AdjacentReality/NodeHardware/SolidModels/sphere_top.stl

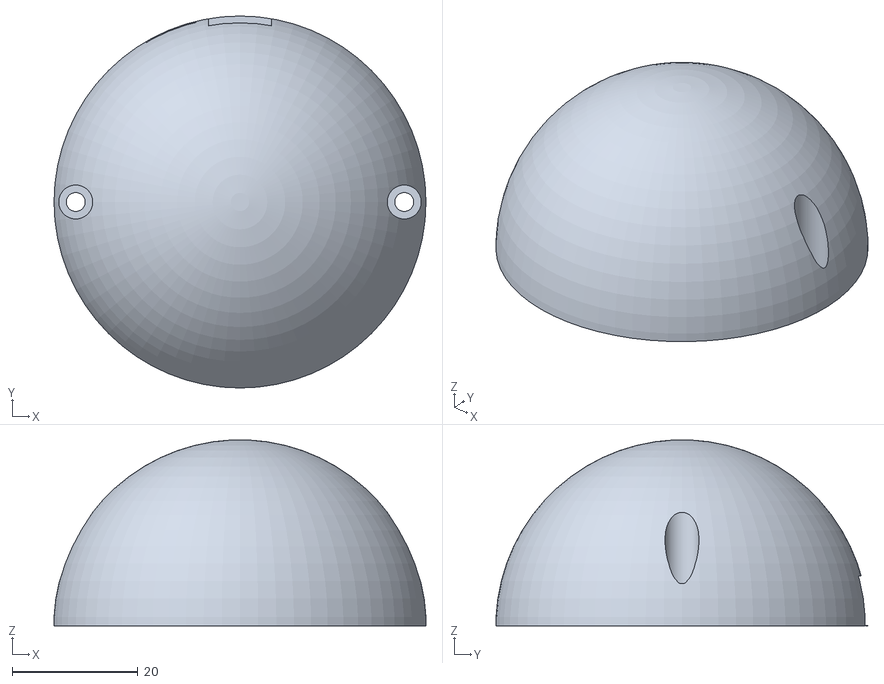
[picture p1: CAD file, 2012-06-10]
SolidModels/sphere_top.stl
59.2 x 59.2 x 29.6
