AdjacentReality/NodeHardware/SolidModels/spray_can_button.stl

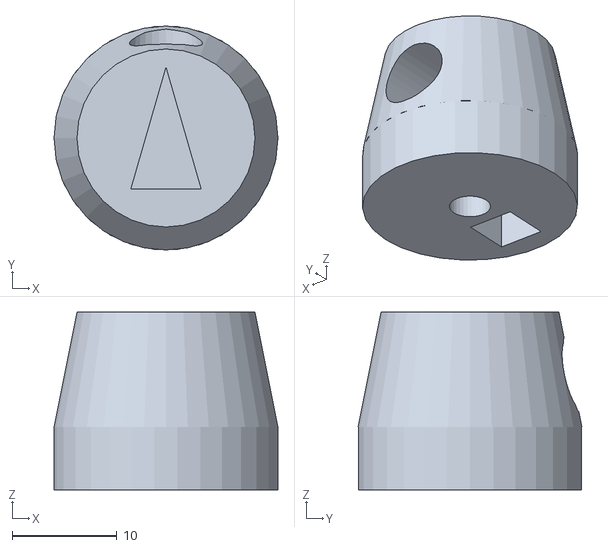
[picture p2: CAD file, 2012-05-16]
SolidModels/spray_can_button.stl
21.4 x 21.4 x 17.0
