AdjacentReality/NodeHardware/SolidModels/spray_can_top.stl

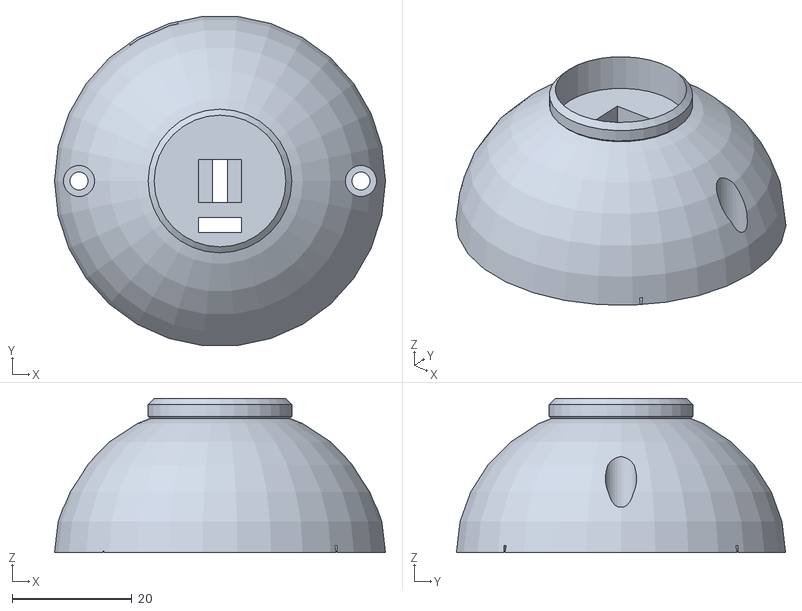
[picture p3: CAD file, 2012-05-15]
SolidModels/spray_can_top.stl
55.3 x 55.0 x 25.8
