AdjacentReality/NodeHardware/SolidModels/spray_can_bottom.stl

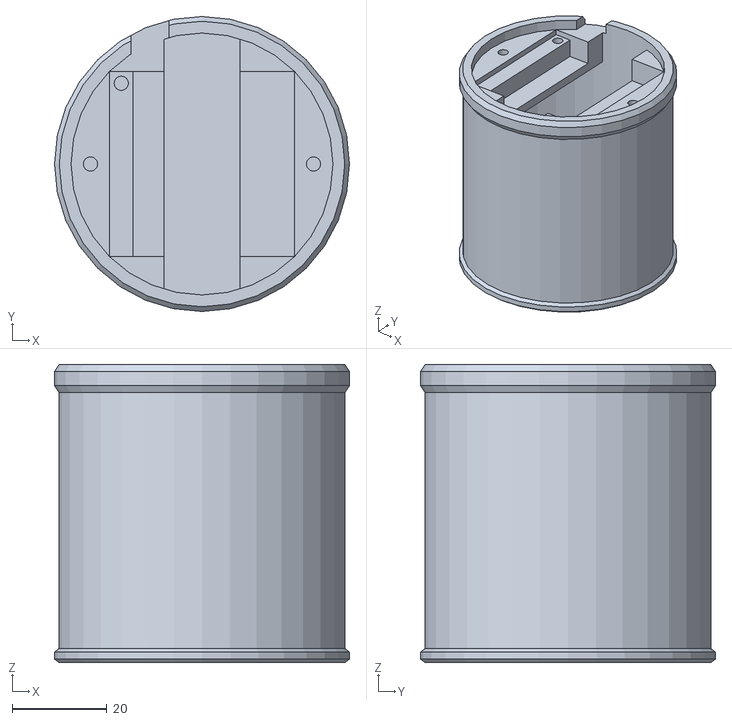
[picture p4: CAD file, 2012-05-15]
SolidModels/spray_can_bottom.stl
62.3 x 62.3 x 63.0
