AdjacentReality/NodeHardware/SolidModels/sphere_bottom.stl

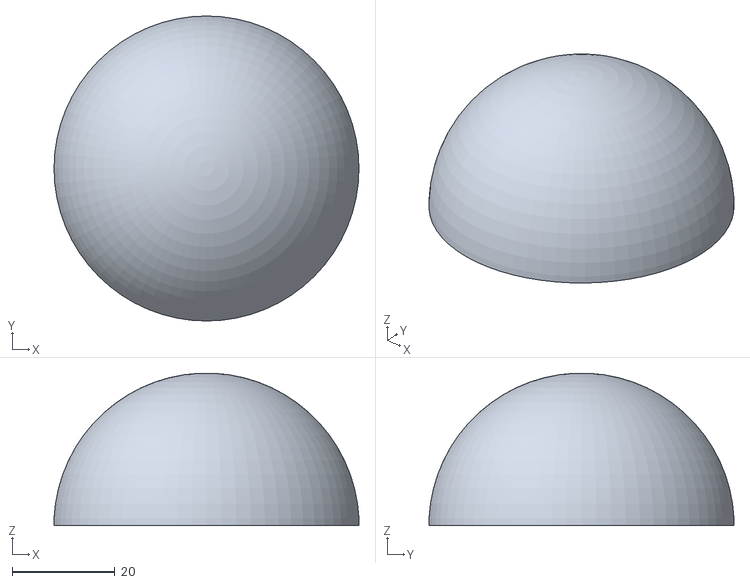
[picture p5: CAD file, 2012-05-15]
SolidModels/sphere_bottom.stl
59.2 x 59.2 x 29.6
