AdjacentReality/NodeHardware/SolidModels/case.stl

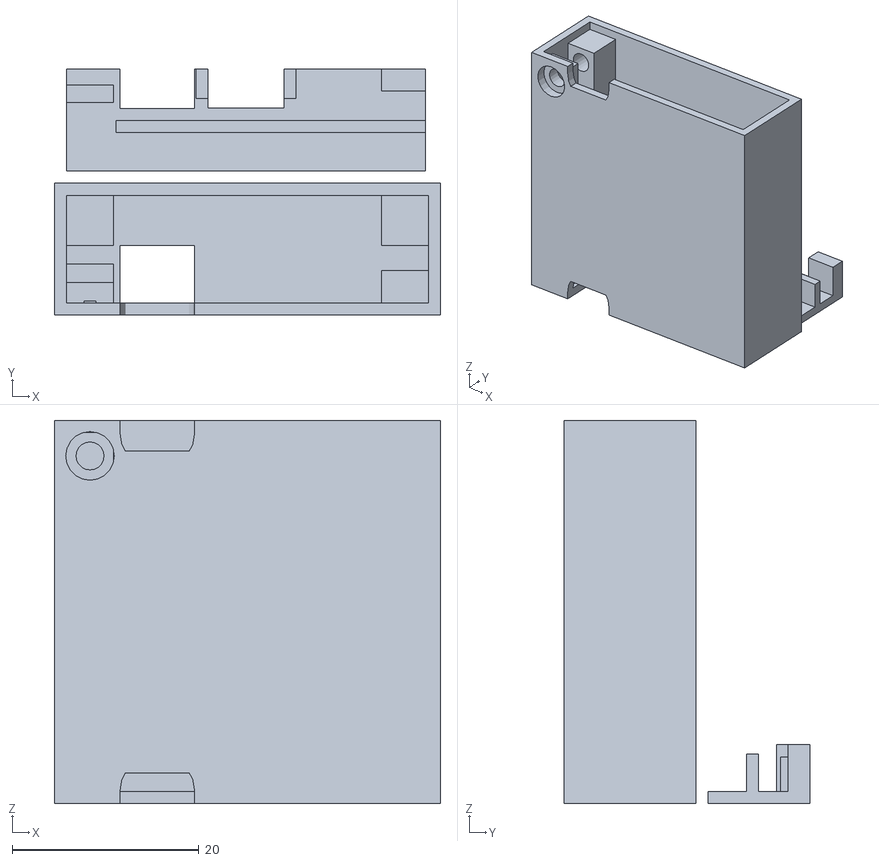
[picture p6: CAD file, 2012-05-07]
SolidModels/case.stl
41.3 x 26.3 x 41.0
