AdjacentReality/NodeHardware/TrackerBaseStation/TrackerBaseStation.brd

## EAGLE design TrackerBaseStation/TrackerBaseStation.brd (2012-07-20)

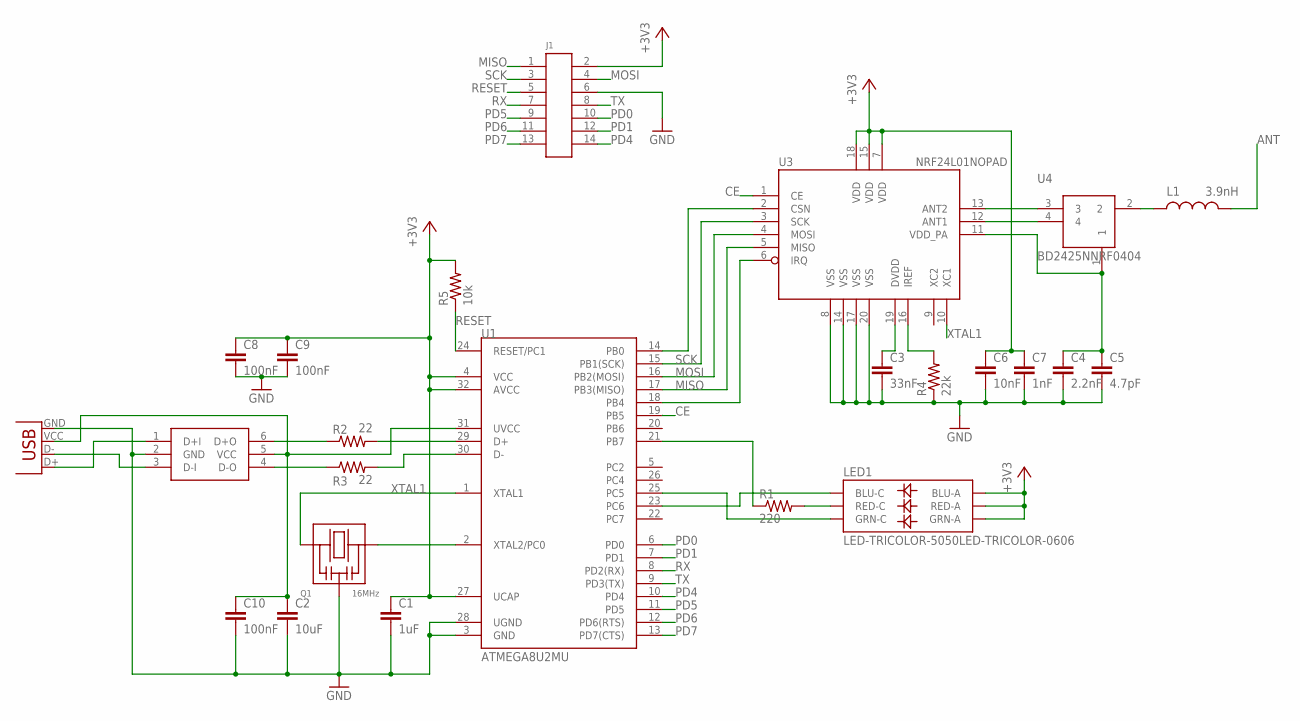
[picture p7: schematic TrackerBaseStation.sch]

Parts:
C1: 1uF; 0402-CAP
C2: 10uF; 0603-CAP
C3: 33nF; 0402-CAP
C4: 2.2nF; 0402-CAP
C5: 4.7pF; 0402-CAP
C6: 10nF; 0402-CAP
C7: 1nF; 0402-CAP
C8, C9, C10: 100nF; 0402-CAP
J1: DF12A3.0-14DS
L1: 3.9nH; C0402
LED1: LED-TRICOLOR-5050LED-TRICOLOR-0606; 0606
Q1: 16MHz; PRQC
R1: 220; 0402-RES
R2, R3: 22; 0402-RES
R4: 22k; 0402-RES
R5: 10k; 0402-RES
U1: ATMEGA8U2MU; QFN32
U2: RCLAMP0502A; SOT-666
U3: NRF24L01NOPAD; QFN20-NOPAD
U4: BD2425NNRF0404; BD2425NNRF
X1: USB-LEG; USB-A-SMD-LEG

Connections:
+3V3: C1.1, C6.1, C7.1, C8.1, C9.1, J1.2, LED1.4 (BLU-A), LED1.5 (RED-A), LED1.6 (GRN-A), R5.2, U1.4 (VCC), U1.27 (UCAP), U1.32 (AVCC), U3.7 (VDD), U3.15 (VDD), U3.18 (VDD)
ANT: L1.2
CE: U1.19 (PB5), U3.1 (CE)
GND: C1.2, C2.2, C3.2, C4.2, C5.2, C6.2, C7.2, C8.2, C9.2, C10.2, J1.6, Q1.P$2 (GND), R4.1, U1.3 (GND), U1.28 (UGND), U2.2 (GND), U3.8 (VSS), U3.14 (VSS), U3.17 (VSS), U3.20 (VSS), X1.GND
MISO: J1.1, U1.17 (PB3(MISO)), U3.5 (MISO)
MOSI: J1.4, U1.16 (PB2(MOSI)), U3.4 (MOSI)
unnamed: LED1.1 (BLU-C), U1.23 (PC6)
unnamed: LED1.2 (RED-C), R1.2
unnamed: R1.1, U1.21 (PB7)
unnamed: LED1.3 (GRN-C), U1.25 (PC5)
unnamed: Q1.P$3 (2), U1.2 (XTAL2/PC0)
unnamed: U2.3 (D-I), X1.D-
unnamed: U2.1 (D+I), X1.D+
unnamed: U1.14 (PB0), U3.2 (CSN)
unnamed: R2.1, U2.6 (D+O)
unnamed: R2.2, U1.29 (D+)
unnamed: R3.1, U2.4 (D-O)
unnamed: R3.2, U1.30 (D-)
unnamed: C2.1, C10.1, U1.31 (UVCC), U2.5 (VCC), X1.VCC (VBUS)
unnamed: U1.18 (PB4), U3.6 (IRQ)
unnamed: C3.1, U3.19 (DVDD)
unnamed: R4.2, U3.16 (IREF)
unnamed: U3.13 (ANT2), U4.3
unnamed: U3.12 (ANT1), U4.4
unnamed: L1.1, U4.2
unnamed: C4.1, C5.1, U3.11 (VDD_PA), U4.1
PD0: J1.10, U1.6 (PD0)
PD1: J1.12, U1.7 (PD1)
PD4: J1.14, U1.10 (PD4)
PD5: J1.9, U1.11 (PD5)
PD6: J1.11, U1.12 (PD6(RTS))
PD7: J1.13, U1.13 (PD7(CTS))
RESET: J1.5, R5.1, U1.24 (RESET/PC1)
RX: J1.7, U1.8 (PD2(RX))
SCK: J1.3, U1.15 (PB1(SCK)), U3.3 (SCK)
TX: J1.8, U1.9 (PD3(TX))
XTAL1: Q1.P$1 (1), U1.1 (XTAL1), U3.10 (XC1)

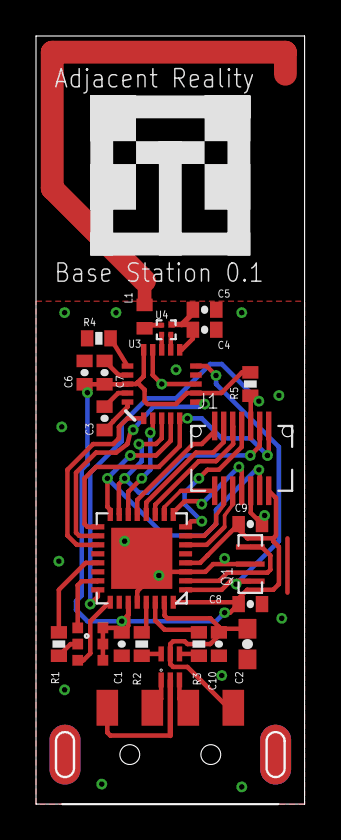
[picture p8: board TrackerBaseStation.brd from above]

Board: 2 copper layers, 14.9 x 42.7 mm, 26 parts (1 on the bottom side), 36 nets.

Other parts of the board:
U$1: ADJACENTREALITY-LOGO-0.35
U$2: OSHW-LOGO-M
