AdjacentReality/NodeHardware/Node.brd

## EAGLE design Node.brd (2012-07-20)

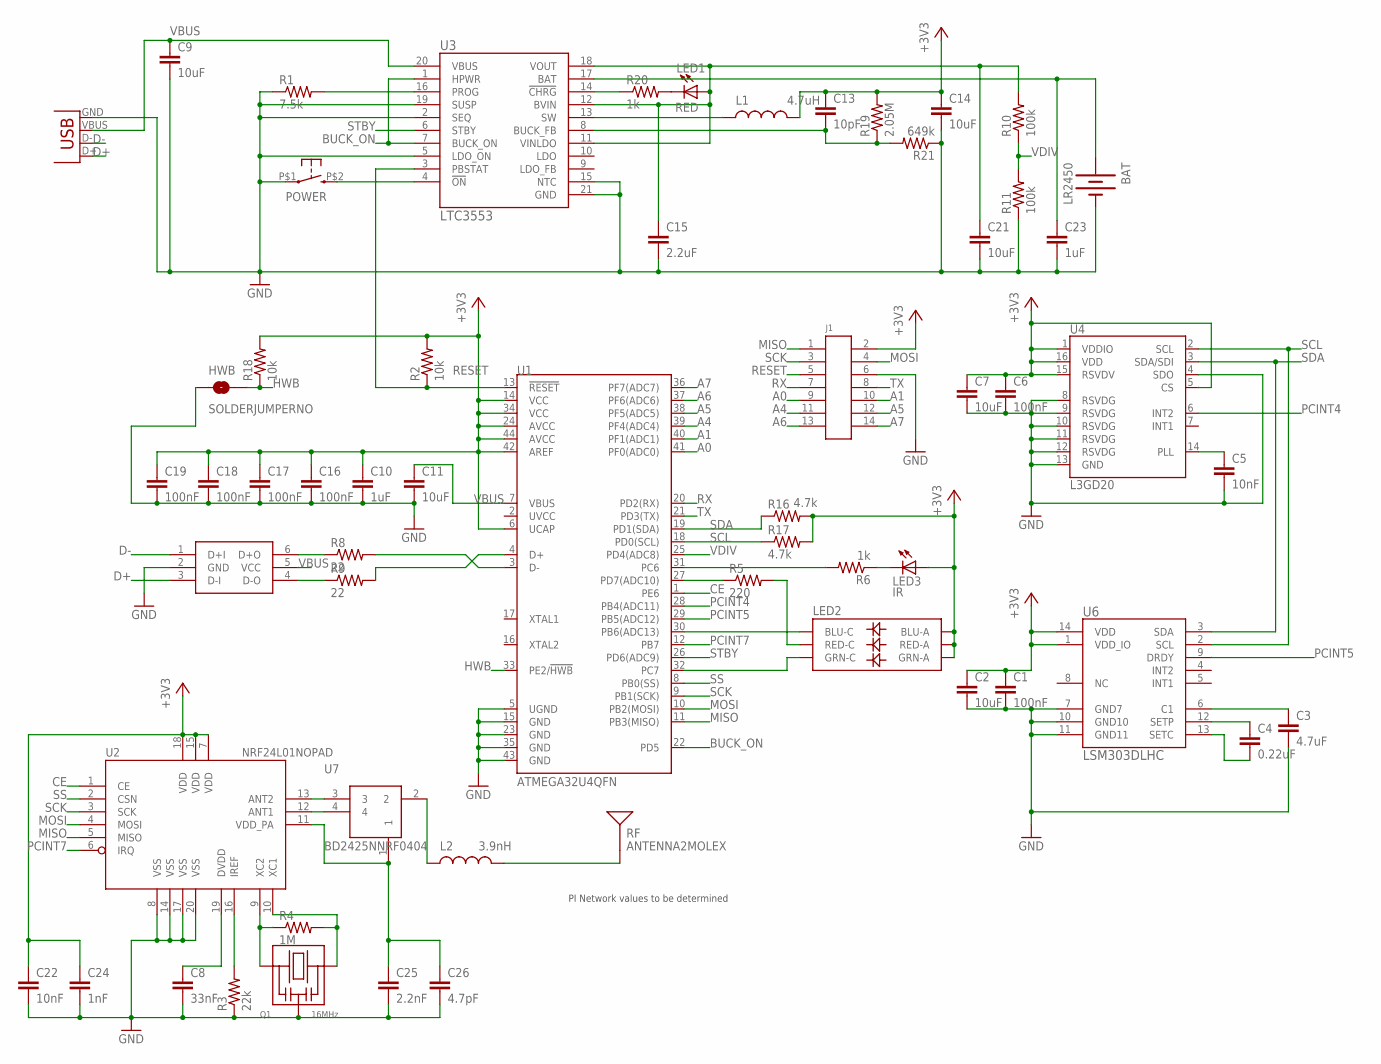
[picture p9: schematic Node.sch]

Parts:
BAT: LR2450; BATTCON_245MM_SLOT
C1, C6, C16, C17, C18, C19: 100nF; 0402-CAP
C2, C7, C9, C11, C14, C21: 10uF; 0603-CAP
C3: 4.7uF; 0603-CAP
C4: 0.22uF; 0402-CAP
C5, C22: 10nF; 0402-CAP
C8: 33nF; 0402-CAP
C10, C23: 1uF; 0402-CAP
C13: 10pF; 0402-CAP
C15: 2.2uF; 0402-CAP
C24: 1nF; 0402-CAP
C25: 2.2nF; 0402-CAP
C26: 4.7pF; 0402-CAP
HWB: SOLDERJUMPERNO; SJ_2S-NO
J1: DF12A3.0-14DS
L1: 4.7uH; VLS30
L2: 3.9nH; C0402
LED1: RED; LED-0603
LED2: LED-TRICOLOR-5050LED-TRICOLOR-0606; 0606
LED3: IR; LED-0603
POWER: KSS
Q1: 16MHz; PRQC
R1: 7.5k; 0402-RES
R2, R18: 10k; 0402-RES
R3: 22k; 0402-RES
R4: 1M; 0402-RES
R5: 220; 0402-RES
R6, R20: 1k; 0402-RES
R8, R9: 22; 0402-RES
R10, R11: 100k; 0402-RES
R16, R17: 4.7k; 0402-RES
R19: 2.05M; 0402-RES
R21: 649k; 0402-RES
RF: ANTENNA2MOLEX; MOLEX2.4SMD
U1: ATMEGA32U4QFN; QFN-44
U2: NRF24L01NOPAD; QFN20-NOPAD
U3: LTC3553; QFN20-3X3
U4: L3GD20; LGA16-4X4
U6: LSM303DLHC; LGA14-3X5
U7: BD2425NNRF0404; BD2425NNRF
U9: RCLAMP0502A; SOT-666
X1: USB-FCI; USB-MICROB-FCI

Connections:
+3V3: C1.1, C2.1, C6.1, C7.1, C10.1, C13.1, C14.1, C16.1, C17.1, C18.1, C19.1, C22.1, C24.1, J1.2, L1.2, LED2.4 (BLU-A), LED2.5 (RED-A), LED2.6 (GRN-A), LED3.A, R2.2, R16.2, R17.2, R18.2, R19.2, U1.6 (UCAP), U1.14 (VCC), U1.24 (AVCC), U1.34 (VCC), U1.42 (AREF), U1.44 (AVCC), U2.7 (VDD), U2.15 (VDD), U2.18 (VDD), U4.1 (VDDIO), U4.5 (CS), U4.15 (RSVDV), U4.16 (VDD), U6.1 (VDD_IO), U6.14 (VDD)
A0: J1.9, U1.41 (PF0(ADC0))
A1: J1.10, U1.40 (PF1(ADC1))
A4: J1.11, U1.39 (PF4(ADC4))
A5: J1.12, U1.38 (PF5(ADC5))
A6: J1.13, U1.37 (PF6(ADC6))
A7: J1.14, U1.36 (PF7(ADC7))
BUCK_ON: U1.22 (PD5), U3.1 (HPWR), U3.7 (BUCK_ON)
CE: U1.1 (PE6), U2.1 (CE)
D+: U9.3 (D-I), X1.D+
D-: U9.1 (D+I), X1.D-
GND: BAT.GND (-), C1.2, C2.2, C3.2, C5.2, C6.2, C7.2, C8.2, C9.2, C10.2, C11.2, C14.2, C15.2, C16.2, C17.2, C18.2, C19.2, C21.2, C22.2, C23.2, C24.2, C25.2, C26.2, HWB.1, J1.6, POWER.P$1 (1), Q1.P$2 (GND), R1.1, R3.1, R11.1, R21.1, U1.5 (UGND), U1.15 (GND), U1.23 (GND), U1.35 (GND), U1.43 (GND), U2.8 (VSS), U2.14 (VSS), U2.17 (VSS), U2.20 (VSS), U3.2 (SEQ), U3.5 (LDO_ON), U3.15 (NTC), U3.19 (SUSP), U3.21 (GND), U4.4 (SDO), U4.8 (RSVDG), U4.9 (RSVDG), U4.10 (RSVDG), U4.11 (RSVDG), U4.12 (RSVDG), U4.13 (GND), U6.7 (GND7), U6.10 (GND10), U6.11 (GND11), U9.2 (GND), X1.GND
HWB: HWB.2, R18.1, U1.33 (PE2/!HWB)
MISO: J1.1, U1.11 (PB3(MISO)), U2.5 (MISO)
MOSI: J1.4, U1.10 (PB2(MOSI)), U2.4 (MOSI)
unnamed: C15.1, C21.1, LED1.A, R10.2, U3.11 (VINLDO), U3.12 (BVIN), U3.18 (VOUT)
unnamed: R1.2, U3.16 (PROG)
unnamed: C3.1, U6.6 (C1)
unnamed: R6.2, U1.31 (PC6)
unnamed: C4.1, U6.12 (SETP)
unnamed: C4.2, U6.13 (SETC)
unnamed: C5.1, U4.14 (PLL)
unnamed: POWER.P$2 (3), U3.4 (!ON)
unnamed: LED2.2 (RED-C), R5.2
unnamed: LED3.C, R6.1
unnamed: C8.1, U2.19 (DVDD)
unnamed: LED2.3 (GRN-C), U1.32 (PC7)
unnamed: LED1.C, R20.2
unnamed: R3.2, U2.16 (IREF)
unnamed: R8.2, U1.3 (D-)
unnamed: R20.1, U3.14 (!CHRG)
unnamed: LED2.1 (BLU-C), U1.30 (PB6(ADC13))
unnamed: R5.1, U1.27 (PD7(ADC10))
unnamed: Q1.P$1 (1), R4.1, U2.9 (XC2)
unnamed: Q1.P$3 (2), R4.2, U2.10 (XC1)
unnamed: U2.13 (ANT2), U7.3
unnamed: U2.12 (ANT1), U7.4
unnamed: C25.1, C26.1, U2.11 (VDD_PA), U7.1
unnamed: R9.2, U1.4 (D+)
unnamed: R8.1, U9.6 (D+O)
unnamed: R9.1, U9.4 (D-O)
unnamed: L1.1, U3.13 (SW)
unnamed: L2.1, U7.2
unnamed: BAT.+1 (+), BAT.+2 (+), BAT.+3 (+), BAT.+4 (+), C23.1, U3.17 (BAT)
unnamed: L2.2, RF.FEED
unnamed: C13.2, R19.1, R21.2, U3.8 (BUCK_FB)
PCINT4: U1.28 (PB4(ADC11)), U4.6 (INT2)
PCINT5: U1.29 (PB5(ADC12)), U6.9 (DRDY)
PCINT7: U1.12 (PB7), U2.6 (IRQ)
RESET: J1.5, R2.1, U1.13 (!RESET), U3.3 (PBSTAT)
RX: J1.7, U1.20 (PD2(RX))
SCK: J1.3, U1.9 (PB1(SCK)), U2.3 (SCK)
SCL: R17.1, U1.18 (PD0(SCL)), U4.2 (SCL), U6.2 (SCL)
SDA: R16.1, U1.19 (PD1(SDA)), U4.3 (SDA/SDI), U6.3 (SDA)
SS: U1.8 (PB0(SS)), U2.2 (CSN)
STBY: U1.26 (PD6(ADC9)), U3.6 (STBY)
TX: J1.8, U1.21 (PD3(TX))
VBUS: C9.1, C11.1, U1.7 (VBUS), U3.20 (VBUS), U9.5 (VCC), X1.VBUS
VDIV: R10.1, R11.2, U1.25 (PD4(ADC8))

Notes on the sheet:
PI Network values to be determined

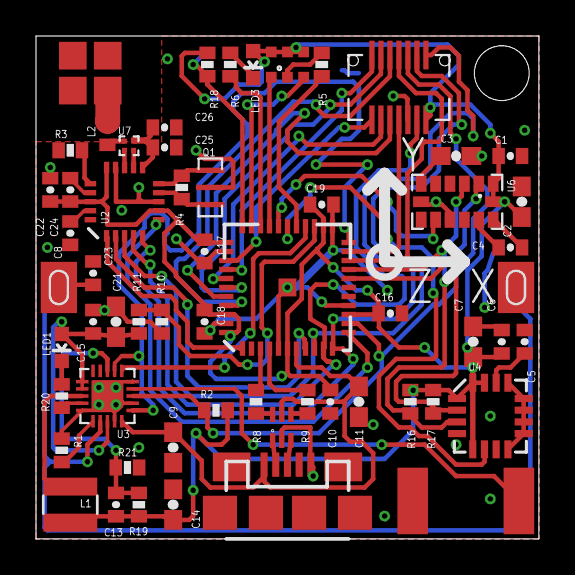
[picture p10: board Node.brd from above]

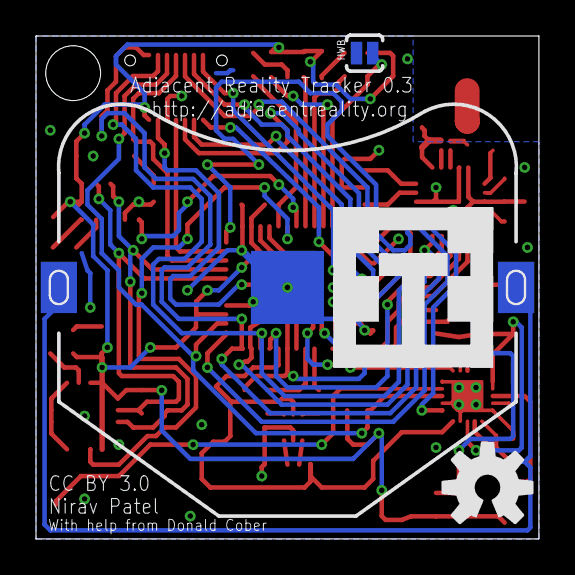
[picture p11: board Node.brd from below]

Board: 2 copper layers, 27.9 x 27.9 mm, 62 parts (4 on the bottom side), 59 nets.

Other parts of the board:
U$1: STAND-OFF-TIGHT
U$2: OSHW-LOGO-M
U$3: ADJACENTREALITY-LOGO-0.35
