AdjacentReality/NodeHardware/TrackerBreakout/TrackerBreakout.brd

## EAGLE design TrackerBreakout/TrackerBreakout.brd (2012-06-25)

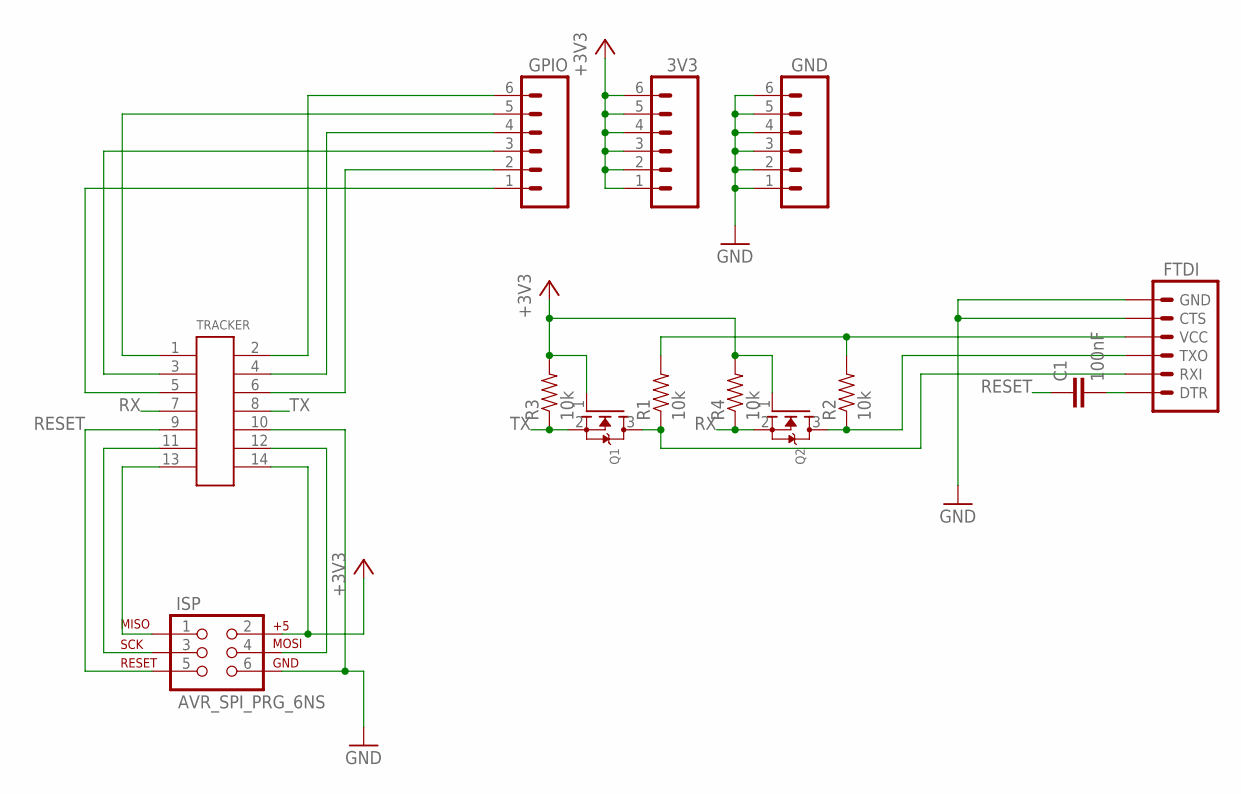
[picture p12: schematic TrackerBreakout.sch]

Parts:
3V3: M06SIP; 1X06
C1: 100nF; 0402-CAP
FTDI: ARDUINO_SERIAL_PROGRAMPTH; 1X06
GND: M06SIP; 1X06
GPIO: M06SIP; 1X06
ISP: AVR_SPI_PRG_6NS; 2X3-NS
Q1, Q2: MOSFET-N; SOT416
R1, R2, R3, R4: 10k; 0402-RES
TRACKER: DF12A3.0-14DS

Connections:
+3V3: 3V3.1, 3V3.2, 3V3.3, 3V3.4, 3V3.5, 3V3.6, ISP.2, Q1.1 (G), Q2.1 (G), R3.2, R4.2, TRACKER.14
GND: FTDI.5 (CTS), FTDI.6 (GND), GND.1, GND.2, GND.3, GND.4, GND.5, GND.6, ISP.6, TRACKER.10
unnamed: GPIO.1, TRACKER.5
unnamed: GPIO.2, TRACKER.6
unnamed: GPIO.3, TRACKER.3
unnamed: GPIO.4, TRACKER.4
unnamed: GPIO.5, TRACKER.1
unnamed: GPIO.6, TRACKER.2
unnamed: ISP.3, TRACKER.11
unnamed: ISP.4, TRACKER.12
unnamed: FTDI.4 (VCC), R1.2, R2.2
unnamed: ISP.1, TRACKER.13
unnamed: C1.2, FTDI.1 (DTR)
unnamed: FTDI.3 (TXO), Q2.3 (D), R2.1
unnamed: FTDI.2 (RXI), Q1.3 (D), R1.1
RESET: C1.1, ISP.5, TRACKER.9
RX: Q2.2 (S), R4.1, TRACKER.7
TX: Q1.2 (S), R3.1, TRACKER.8

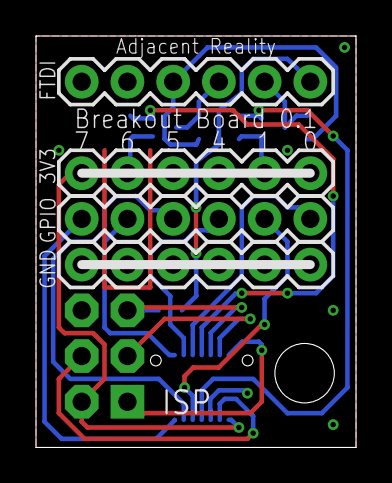
[picture p13: board TrackerBreakout.brd from above]

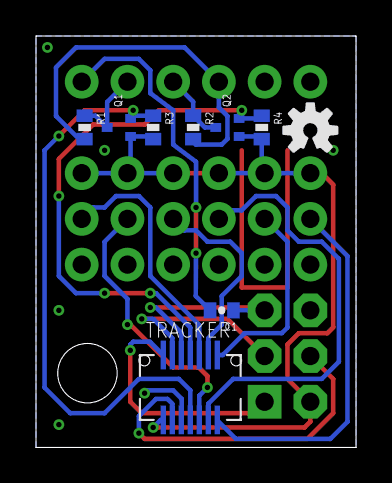
[picture p14: board TrackerBreakout.brd from below]

Board: 2 copper layers, 17.8 x 22.9 mm, 15 parts (9 on the bottom side), 18 nets.

Other parts of the board:
U$1: STAND-OFF
U$2: OSHW-LOGO-S
