AdjacentReality/NodeHardware/(commit log)

2012-02-13 Make a repository covering only Node hardware files
    [Node.brd, Node.sch]
2012-04-12 starting rev 2, using LTC3554
    [Node.brd, Node.sch]
2012-04-13 properly decouple LTC3554
    [Node.brd, Node.sch]
2012-04-13 and one more 1uF for the battery
    [Node.brd, Node.sch]
2012-04-14 swap 32u4 to tfqp, flip battery, LSM303DLHC
    [Node.brd, Node.sch]
2012-04-14 add VLS30 inductor package
    [Node.brd, Node.sch]
2012-04-14 add header for power button
    [Node.brd, Node.sch]
2012-04-14 start of board layout
    [Node.brd]
2012-04-14 it all sort of fits in the box
    [Node.brd, Node.sch]
2012-04-14 mostly realistic parts placement
    [Node.brd]
2012-04-14 pass ERC
    [Node.brd, Node.sch]
2012-04-14 mostly pass DRC
    [Node.brd]
2012-04-15 more routing
    [Node.brd, Node.sch]
2012-04-15 route header
    [Node.brd]
2012-04-15 mostly complete routing
    [Node.brd]
2012-04-15 fix a bunch of tiny air wires
    [Node.brd]
2012-04-15 one wire left
    [Node.brd]
2012-04-15 the rats have flown the nest
    [Node.brd]
2012-04-15 move the user button and stand-off
    [Node.brd]
2012-04-15 labels on top layer
    [Node.brd, Node.sch]
2012-04-15 nearly complete bottom silkscreen
    [Node.brd]
2012-04-16 12mil ground pour isolation
    [Node.brd]
2012-04-16 bottom layer silkscreen
    [Node.brd]
2012-04-16 update to eagle 6.2.0
    [Node.brd]
2012-05-06 basic enclosure for Tracker 0.2
    [case.scad, case.stl]
2012-05-07 improve case lid
    [case.scad, case.stl]
2012-05-15 sphere and spray can cases
    [sphere.scad, sphere_bottom.stl, sphere_top.stl, spray_can.scad, spray_can_bottom.stl, spray_can_button.stl, spray_can_top.stl]
2012-05-16 fix spray can button shape
    [spray_can.scad, spray_can_button.stl]
2012-06-10 sphere cutout
    [sphere.scad, sphere_top.stl]
2012-06-10 cleanup for rev3 and use ltc3553
    [Node.brd, Node.sch]
2012-06-15 add header and crystal
    [Node.brd, Node.sch]
2012-06-16 balun for nrf24l01
    [Node.brd, Node.sch]
2012-06-16 add the antenna
    [Node.brd, Node.sch]
2012-06-16 cleanup some names
    [Node.brd, Node.sch]
2012-06-17 start of base station
    [Node.brd, Node.sch]
2012-06-18 usb port parts
    [Node.brd, Node.sch]
2012-06-18 mostly complete base station
    [TrackerBaseStation.sch]
2012-06-18 pin header for base station
    [Node.brd, Node.sch, TrackerBaseStation.sch]
2012-06-18 breakout board schematic
    [TrackerBreakout.sch]
2012-06-22 start of 0.3 layout
    [Node.brd, Node.sch]
2012-06-24 start of base station layout
    [Node.brd, TrackerBaseStation.brd, TrackerBaseStation.sch]
2012-06-24 with antenna
    [TrackerBaseStation.brd, TrackerBaseStation.sch]
2012-06-25 Breakout Board layout
    [TrackerBreakout.brd, TrackerBreakout.sch]
2012-06-25 fix connector direction
    [TrackerBreakout.brd, TrackerBreakout.sch]
2012-06-25 a few more painful wires
    [Node.brd]
2012-06-25 so close
    [Node.brd, TrackerBreakout.brd]
2012-06-26 the slow and steady march to zero airwires
    [Node.brd]
2012-06-26 7 more to go
    [Node.brd]
2012-06-26 all of the real airwires?
    [Node.brd]
2012-06-26 with silkscreen
    [Node.brd]
2012-07-20 fix capacitor size and nrf cream layer
    [Node.brd, Node.sch, TrackerBaseStation.brd, TrackerBaseStation.sch]
