AdjacentReality/NodeHardware/(notices)

Notices in the files:
Node.brd:
CC BY 3.0
TrackerBaseStation/TrackerBaseStation.brd:
Creative Commons By
parts and their libraries:
adjacent-reality: CC-BY-SA from SparkFun?
adjacent-reality: CC BY SA SparkFun
SparkFun: Licensing: CC v3.0 Share-Alike You are welcome to use this library for commercial purposes.
